michael-betz/DrGreenThumb/PCB/front.jpg

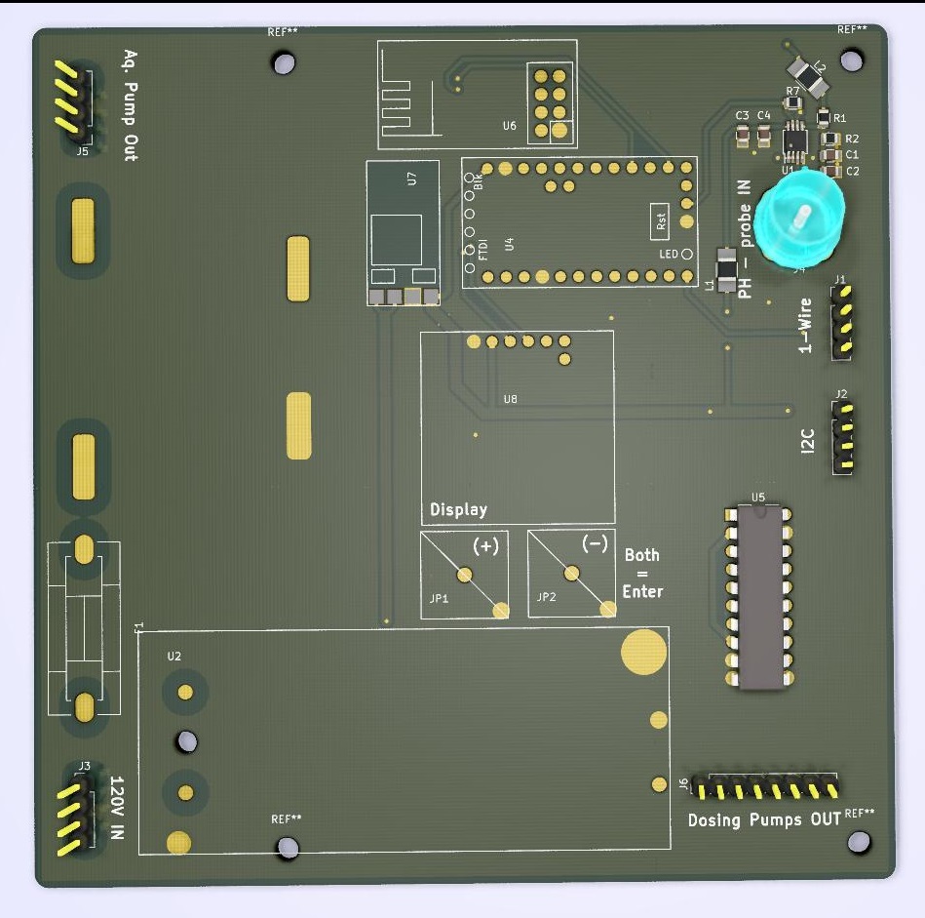
PCB/front.jpg
