michael-betz/DrGreenThumb/PCB/back.jpg

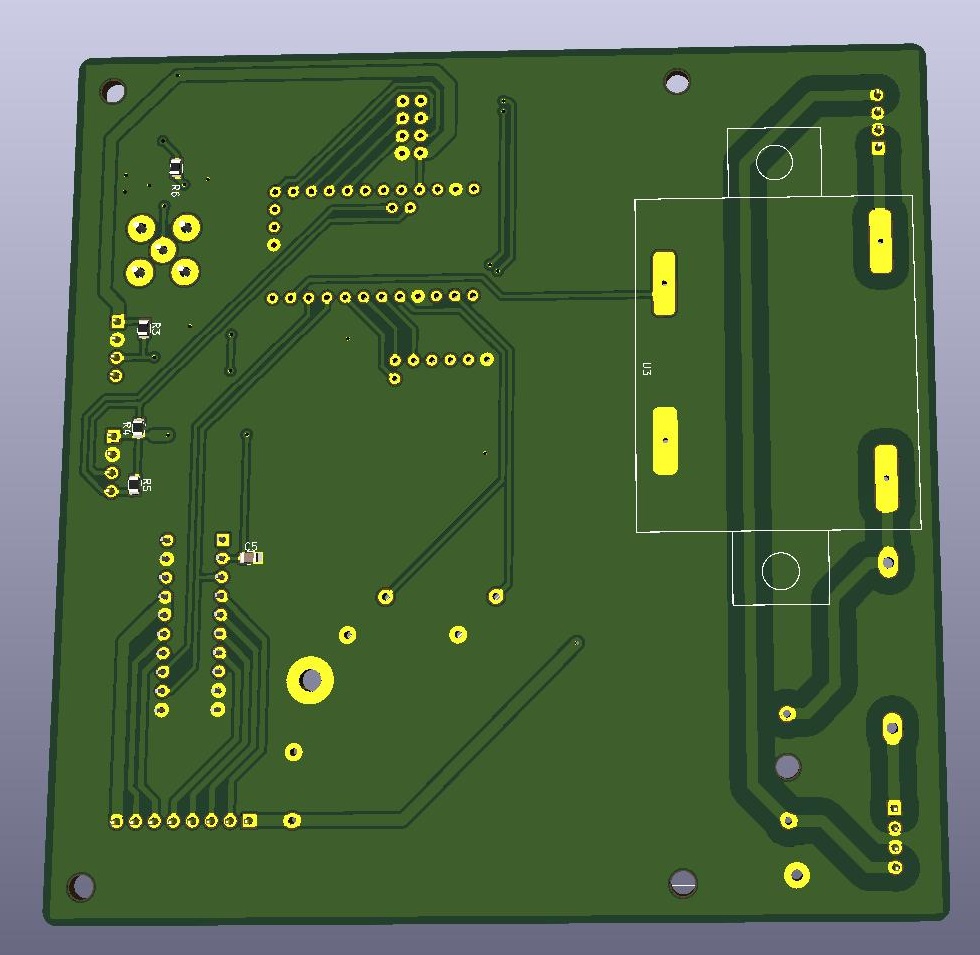
PCB/back.jpg
