michael-betz/DrGreenThumb/phCalibration/phCal.png

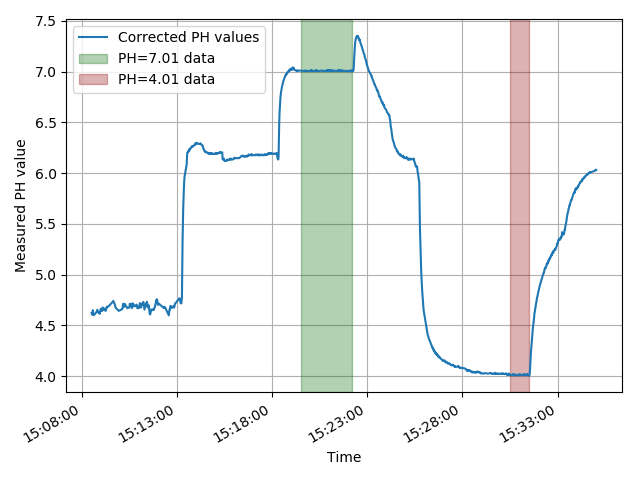
phCalibration/phCal.png
