michael-betz/DrGreenThumb/PCB/DrGreenThumb.pdf

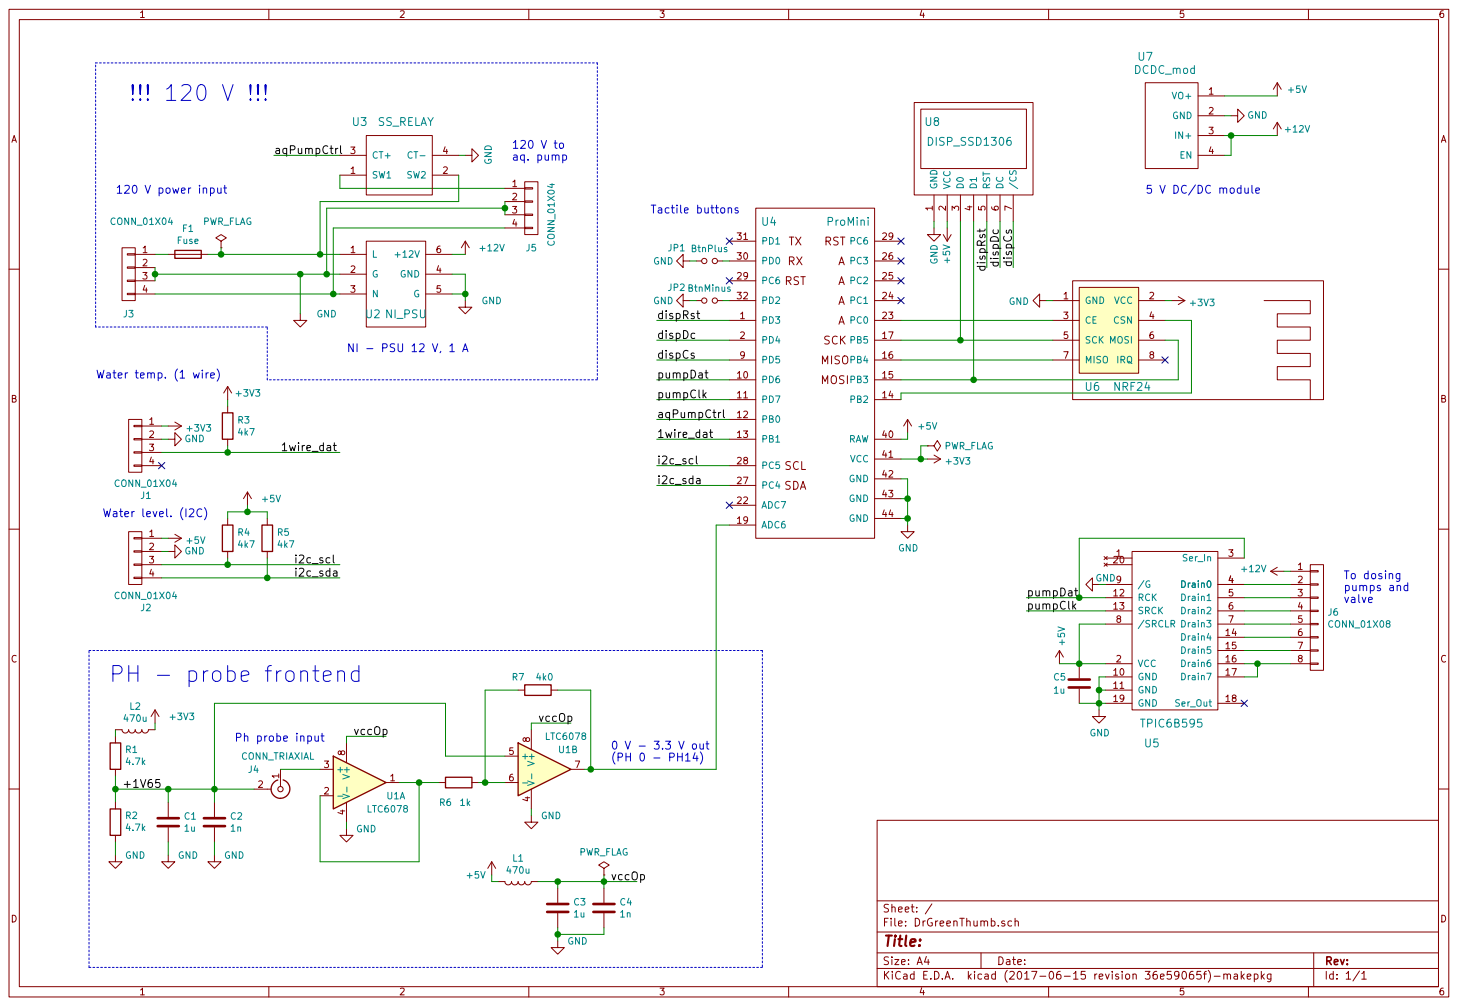
[picture p4: page 1]

7 U8DISP_SSD1306 GND +5V dispRst dispDc dispCs

JP2 BtnMinus GND GND Tactile buttons

/G 9 GND 10 | 4

/SRCLR 8 | 5

Id: 1/1 Title: File: DrGreenThumb.sch Sheet: /
