michael-betz/DrGreenThumb/PCB/ltspice/LTC6078_TA10.asc

B1: bv; V=59.2m*({pH}-7)
C1: cap; 1000p
R1: res; 4.0k
R2: res; 1K
R3: res; 4.7k
R4: res; 4.7k
U1: LTC6078
U2: LTC6078
V1: voltage; 5
V3: voltage; 3.3
V4: voltage; 0
Named nets: OUT, 0, +V, -V, +IN, -IN
LTC6078 - µPower Precision, Dual CMOS Rail-to-Rail Input/Output Amplifiers
pH Probe Amplifier
Notes:
  If the simulation model is not found please update with the "Sync Release" command from the "Tools" menu.
  It remains the customer's responsibility to verify proper and reliable operation in the actual application.
  Component substitution and printed circuit board layout may significantly affect circuit performance or reliability.
  Contact your local sales representative for assistance. This circuit is distributed to customers only for use with LTC parts.
  Copyright © 2016 Linear Technology Inc.  All rights reserved.
pH Probe
.step param pH 0 14 1
.tran 5m
