michael-betz/DrGreenThumb/PCB/DrGreenThumb.kicad_pcb

## KiCad design PCB/DrGreenThumb.kicad_pcb (2017-07-19)

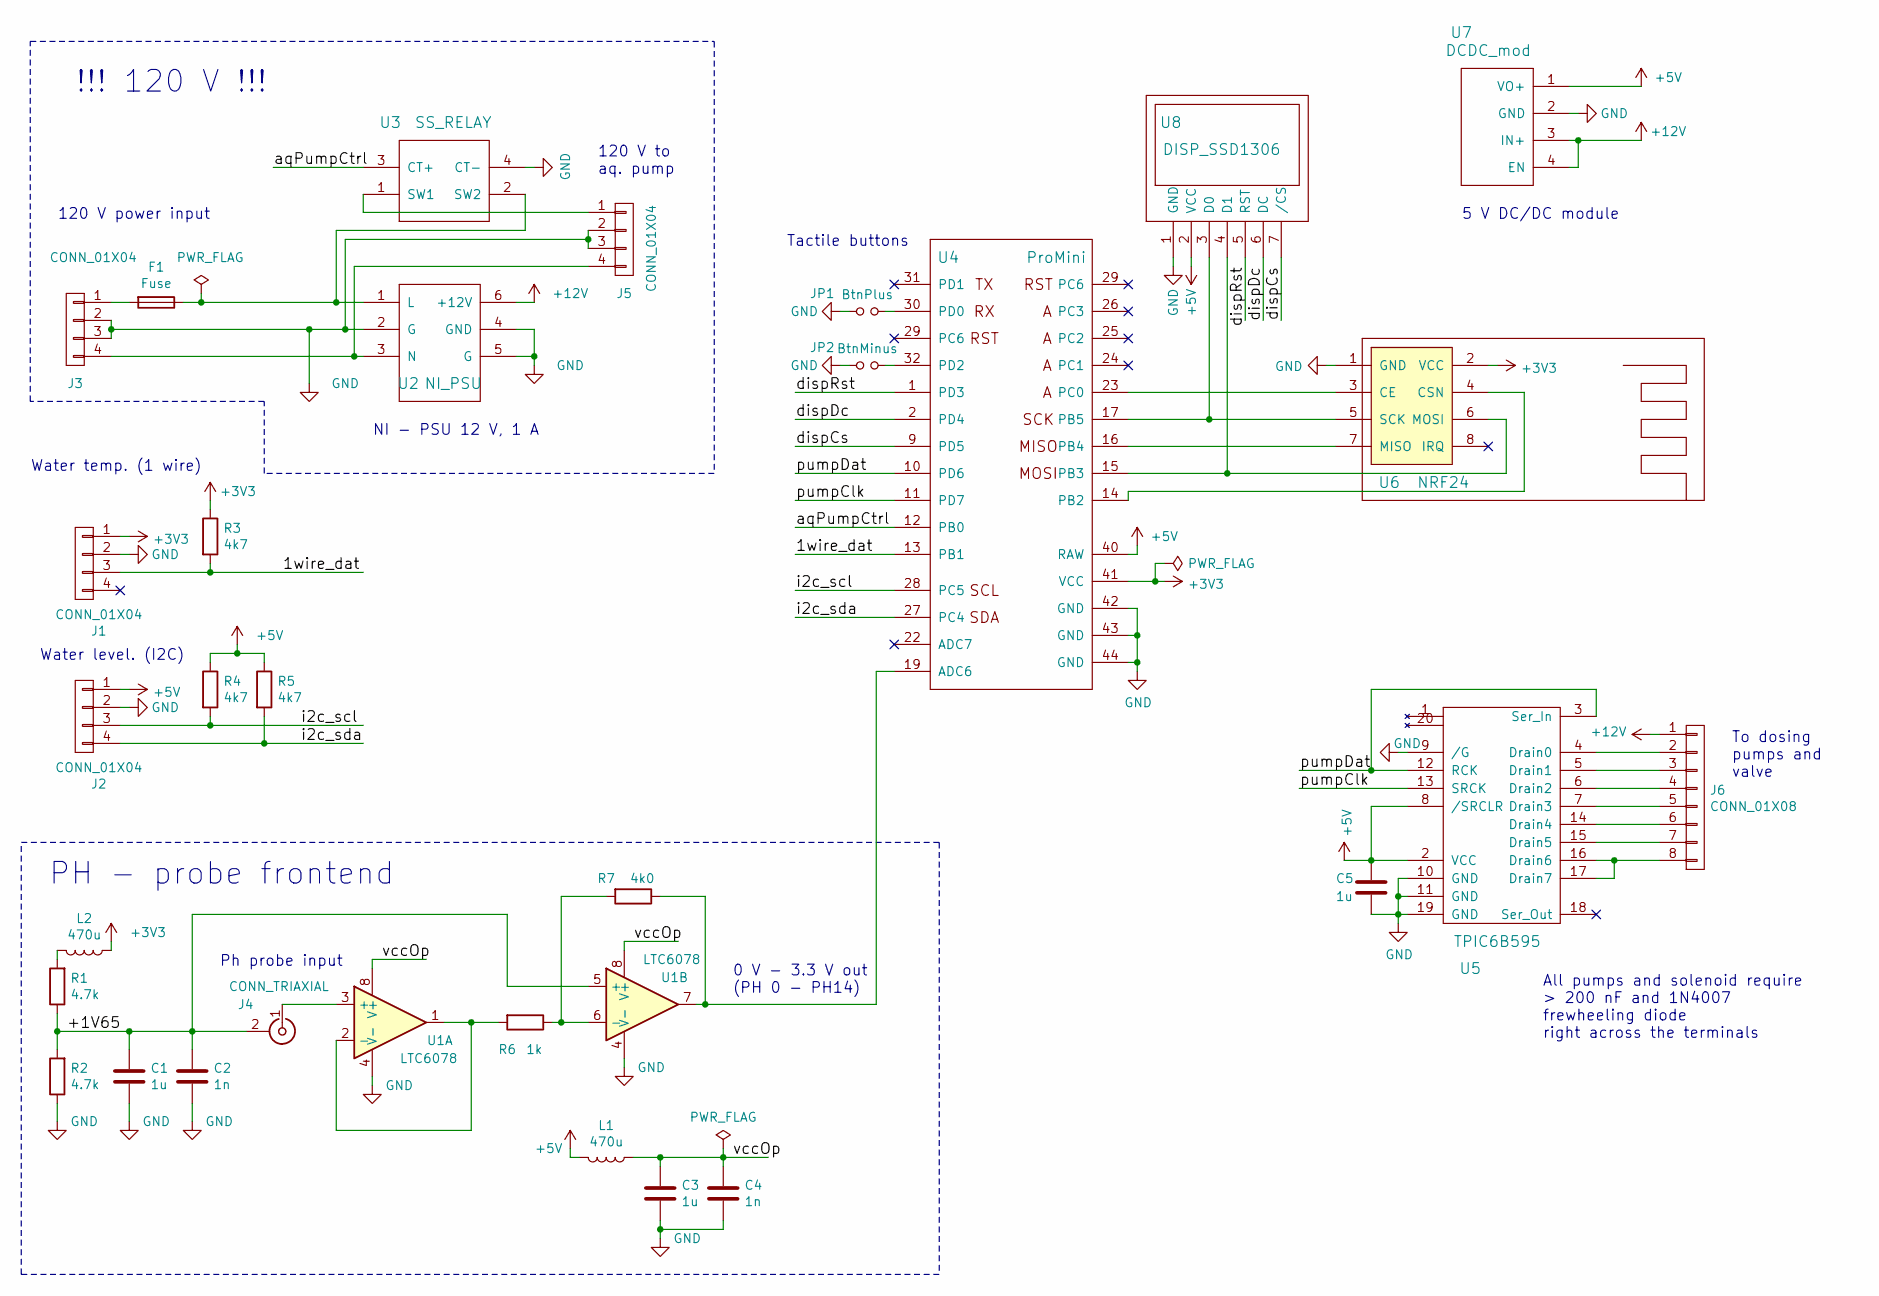
[picture p5: schematic DrGreenThumb.sch]

Parts:
C1, C3, C5: 1u; C_0805
C2, C4: 1n; C_0805
F1: Fuse; Fuseholder5x20_horiz_SemiClosed_Casing10x25mm
J1, J2, J3, J5: CONN_01X04; Pin_Header_Straight_1x04_Pitch2.54mm
J4: CONN_TRIAXIAL; bnc-ci
J6: CONN_01X08; Pin_Header_Straight_1x08_Pitch2.54mm
JP1: BtnPlus; ITT_TACT
JP2: BtnMinus; ITT_TACT
L1, L2: 470u; R_1210_HandSoldering
R1, R2: 4.7k; R_0805
R3, R4, R5: 4k7; R_0805
R6: 1k; R_0805
R7: 4k0; R_0805
U1: LTC6078; MSOP-8_3x3mm_Pitch0.65mm
U2: NI_PSU
U3: SS_RELAY
U4: ProMini; PRO_MINI
U5: TPIC6B595; DIP-20_W7.62mm
U6: NRF24
U7: DCDC_mod; ebay_dcdc
U8: DISP_SSD1306

Connections:
+3V3: J1.1, L2.1, R3.1, U4.41 (VCC), U6.2 (VCC)
+5V: C5.1, J2.1, L1.2, R4.1, R5.1, U4.40 (RAW), U5.2 (VCC), U5.8 (/SRCLR), U7.1 (VO+), U8.2 (VCC)
+12V: J6.1, U2.6 (+12V), U7.3 (IN+), U7.4 (EN)
/1wire_dat: J1.3, R3.2, U4.13 (PB1)
/+1V65: C1.1, C2.1, J4.2 (Ext), R1.1, R2.2, U1.5 (+)
/aqPumpCtrl: U3.3 (CT+), U4.12 (PB0)
/dispCs: U4.9 (PD5), U8.7 (/CS)
/dispDc: U4.2 (PD4), U8.6 (DC)
/dispRst: U4.1 (PD3), U8.5 (RST)
/i2c_scl: J2.3, R4.2, U4.28 (PC5)
/i2c_sda: J2.4, R5.2, U4.27 (PC4)
/pumpClk: U4.11 (PD7), U5.13 (SRCK)
/pumpDat: U4.10 (PD6), U5.3 (Ser_In), U5.12 (RCK)
/vccOp: C3.1, C4.1, L1.1, U1.8 (V+)
GND: C1.2, C2.2, C3.2, C4.2, C5.2, J1.2, J2.2, J3.2, J3.3, J5.2, J5.3, JP1.1, JP2.1, R2.1, U1.4 (V-), U2.2 (G), U2.4 (GND), U2.5 (G), U3.4 (CT-), U4.42 (GND), U4.43 (GND), U4.44 (GND), U5.9 (/G), U5.10 (GND), U5.11 (GND), U5.19 (GND), U6.1 (GND), U7.2 (GND), U8.1 (GND)
unnamed: F1.1, U2.1 (L), U3.2 (SW2)
unnamed: F1.2, J3.1
unnamed: J3.4, J5.4, U2.3 (N)
unnamed: J4.1 (In), U1.3 (+)
unnamed: J5.1, U3.1 (SW1)
unnamed: J6.2, U5.4 (Drain0)
unnamed: J6.3, U5.5 (Drain1)
unnamed: J6.4, U5.6 (Drain2)
unnamed: J6.5, U5.7 (Drain3)
unnamed: J6.6, U5.14 (Drain4)
unnamed: J6.7, U5.15 (Drain5)
unnamed: J6.8, U5.16 (Drain6), U5.17 (Drain7)
unnamed: JP1.2, U4.30 (PD0)
unnamed: JP2.2, U4.32 (PD2)
unnamed: L2.2, R1.2
unnamed: R6.1, R7.2, U1.6 (-)
unnamed: R6.2, U1.1, U1.2 (-)
unnamed: R7.1, U1.7, U4.19 (ADC6)
unnamed: U4.14 (PB2), U6.4 (CSN)
unnamed: U4.15 (PB3), U6.6 (MOSI), U8.4 (D1)
unnamed: U4.16 (PB4), U6.7 (MISO)
unnamed: U4.17 (PB5), U6.5 (SCK), U8.3 (D0)
unnamed: U4.23 (PC0), U6.3 (CE)

Notes on the sheet:
Ph probe input
To dosing pumps and valve
Water temp. (1 wire)
120 V to aq. pump
5 V DC/DC module
Water level. (I2C)
120 V power input
NI - PSU 12 V, 1 A
!!! 120 V !!!
0 V - 3.3 V out (PH 0 - PH14)
PH - probe frontend
Tactile buttons
All pumps and solenoid require > 200 nF and 1N4007 frewheeling diode right across the terminals

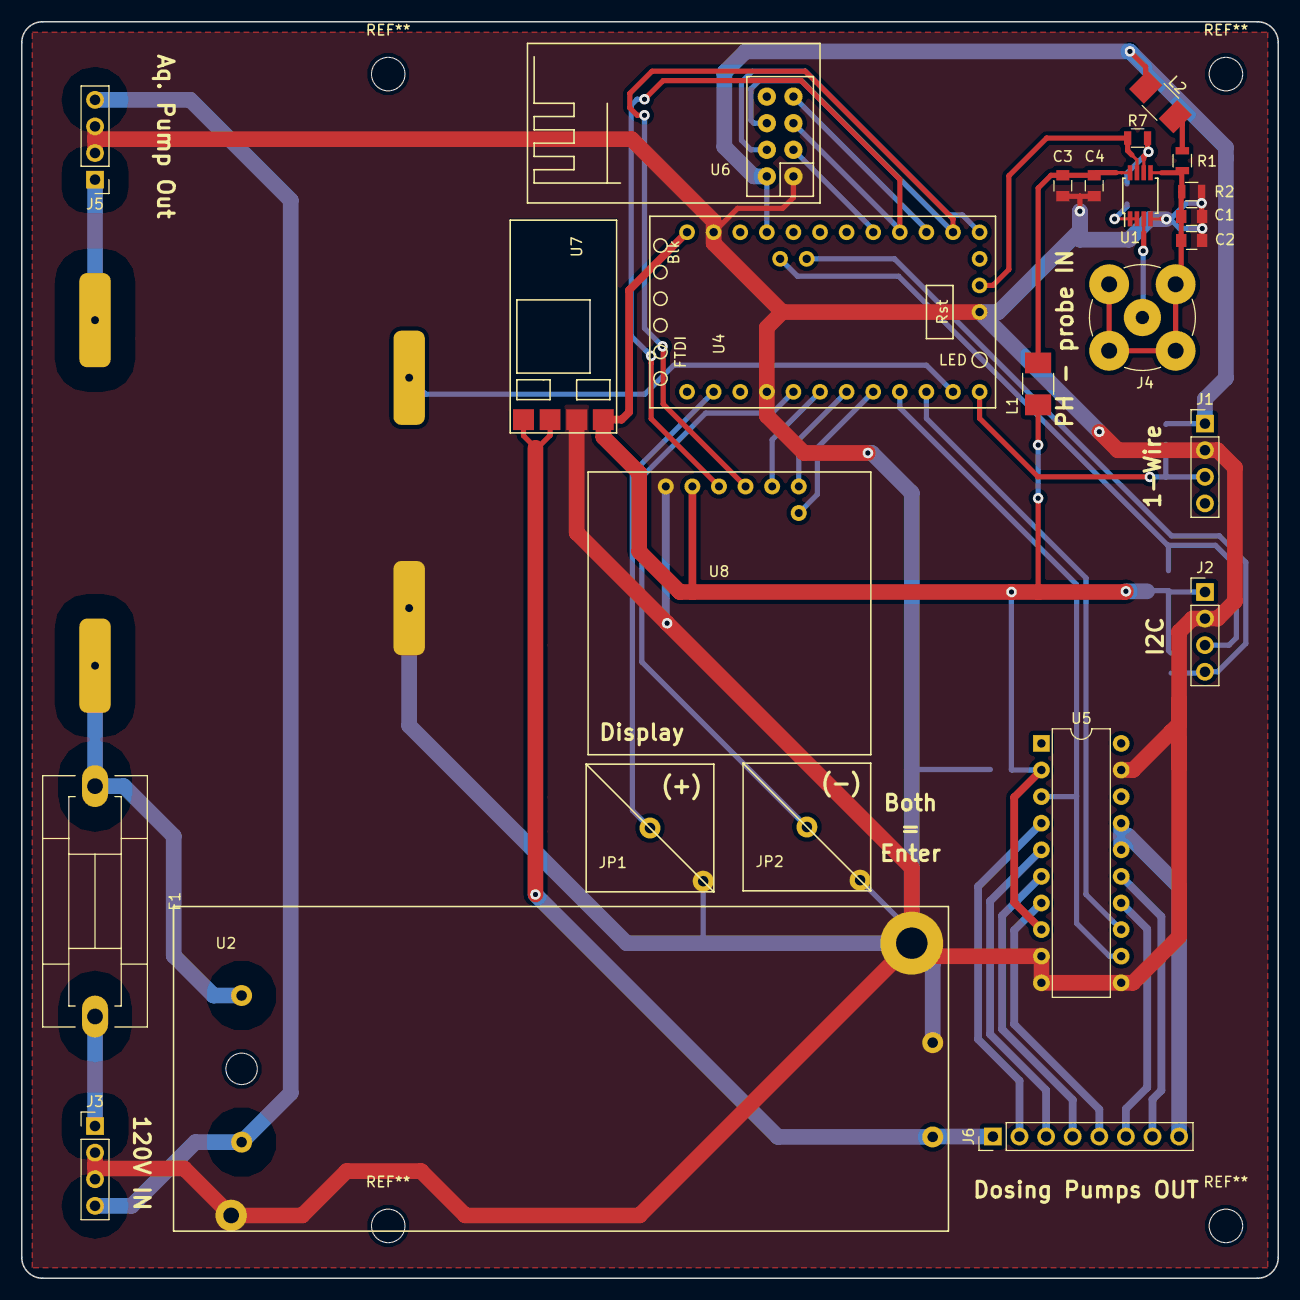
[picture p6: board DrGreenThumb.kicad_pcb from above]

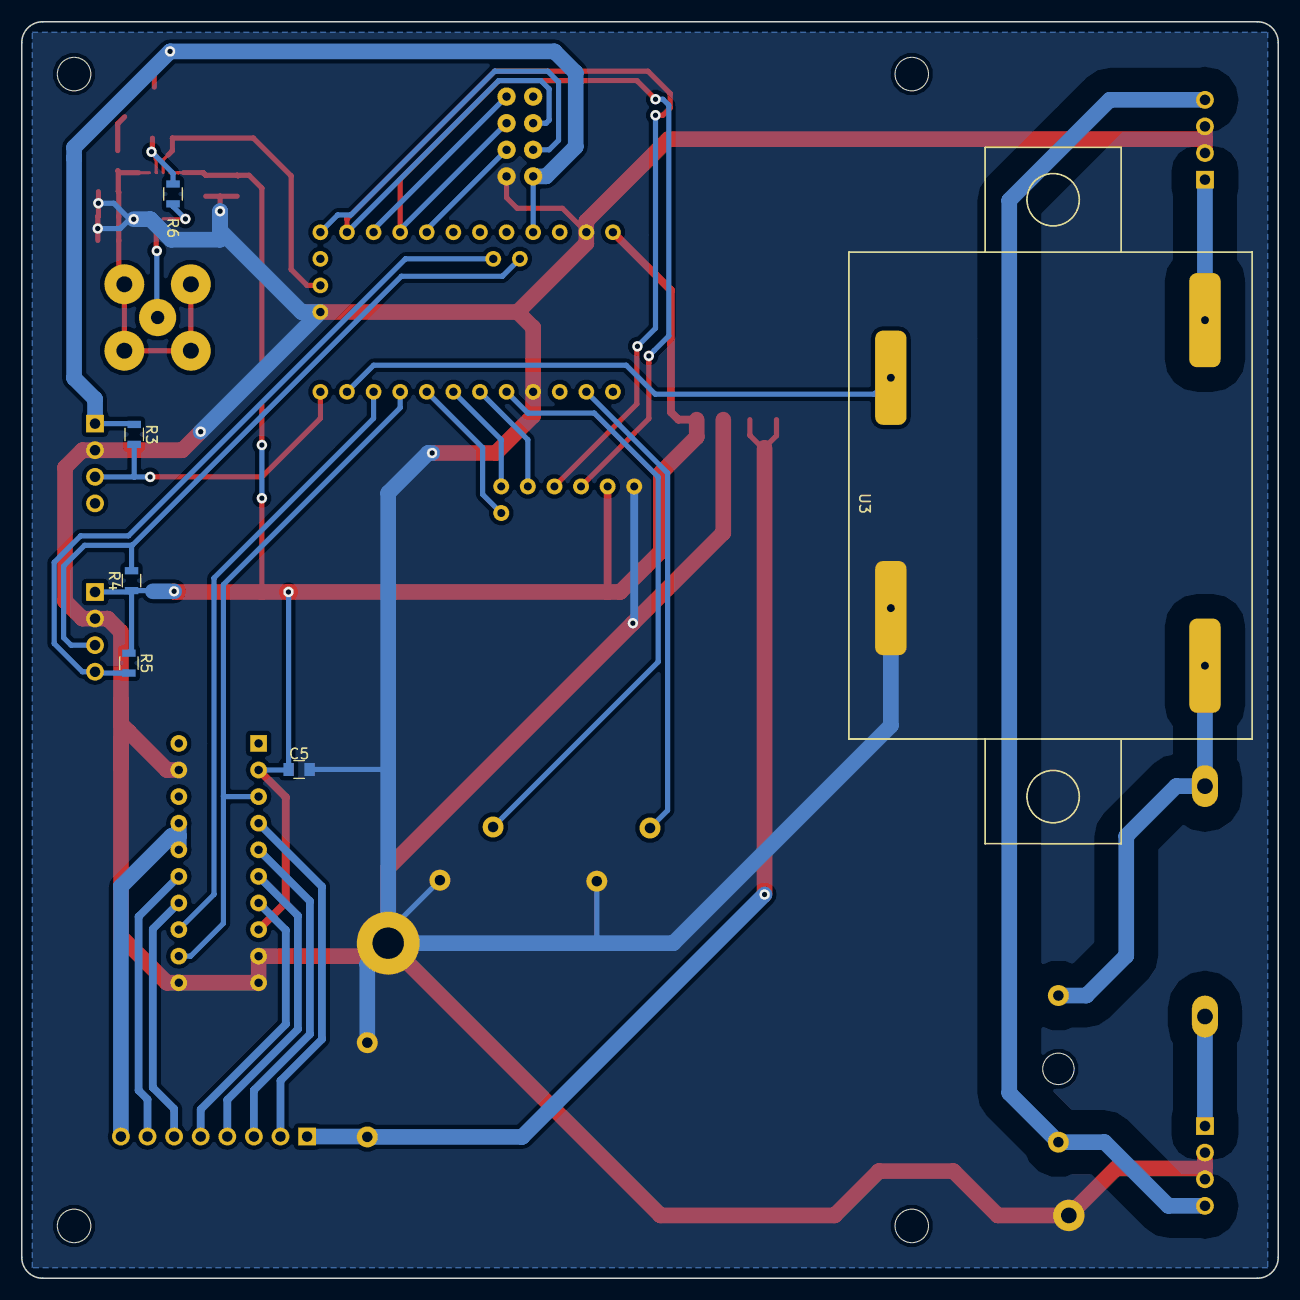
[picture p7: board DrGreenThumb.kicad_pcb from below]

Board: 2 copper layers, 120.0 x 120.0 mm, 31 parts (6 on the bottom side), 38 nets.
