michael-betz/DrGreenThumb/myNRF24.h

/*
 * myNRF24.c
 *
 *  Created on: May 8, 2014
 *      Author: michael
 */

#ifndef MYNRF24_C_
#define MYNRF24_C_
#include <inttypes.h>

extern uint8_t cacheCONFIG;
#define NRF_PWR_UP()   { SBI( cacheCONFIG, PWR_UP);  nRfWrite_register( CONFIG, cacheCONFIG ); }
#define NRF_PWR_DOWN() { CBI( cacheCONFIG, PWR_UP);  nRfWrite_register( CONFIG, cacheCONFIG ); }
#define NRF_RX_MODE()  { SBI( cacheCONFIG, PRIM_RX); nRfWrite_register( CONFIG, cacheCONFIG ); }
#define NRF_TX_MODE()  { CBI( cacheCONFIG, PRIM_RX); nRfWrite_register( CONFIG, cacheCONFIG ); }

void nRfInit();
void nRfInitTX();
void nRfInitRX();
void nRfSendBytes( uint8_t *bytesToSend, uint8_t len, uint8_t noAck );
uint8_t nRfIsRxDataReady();
void nRfHandleISR();

void nRfHexdump( void );

#endif /* MYNRF24_C_ */
