michael-betz/DrGreenThumb/(commit log)

2017-06-24 ADC and pump driver works
2017-06-25 ADC averaging factor
2017-06-29 both pumps, adc and nRF24 works
2017-06-30 added good timer
2017-07-03 Added Kicad PCB files
    [DrGreenThumb.kicad_pcb, DrGreenThumb.sch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]
2017-07-19 Fixed radical bug in mySPI_avr, always sendind with noAck
    [debugPrint.c, debugPrint.h, i2cmaster.c, i2cmaster.h, main.c, main.h]
2017-07-25 Water level now filtered and a fixed point float. Added basic dosing pump interface
    [main.c, main.h]
2017-08-20 Added PH calibration worksheet
