michael-betz/DrGreenThumb/(notices)

Notices in the files:
myUtil/1_wire/README.md:
The MIT License
